rubemnobre/alouatta/Hardware/prototype.png

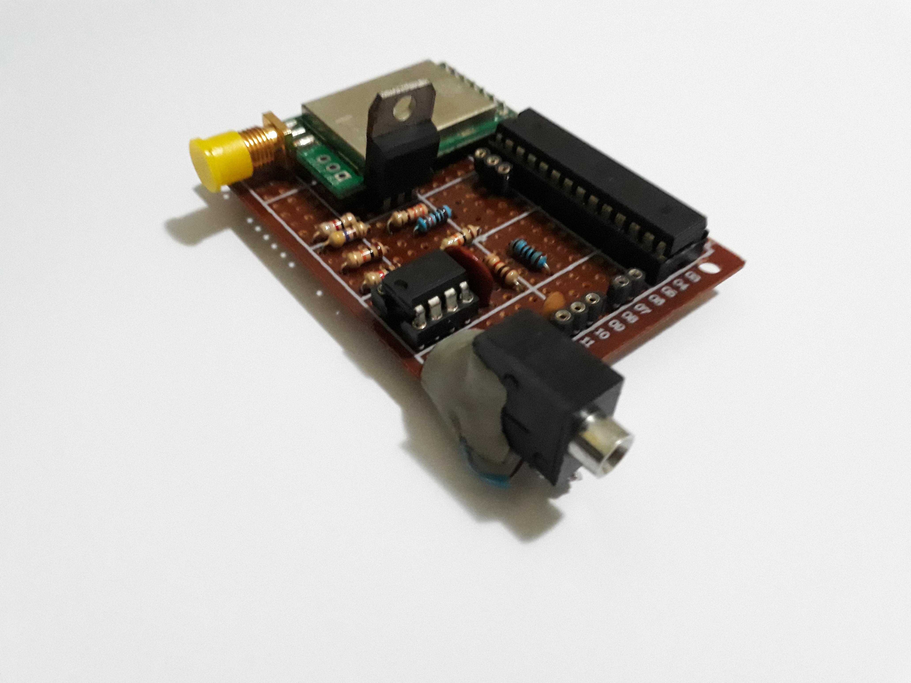
Hardware/prototype.png
