rubemnobre/alouatta/Hardware/schematics-node.png

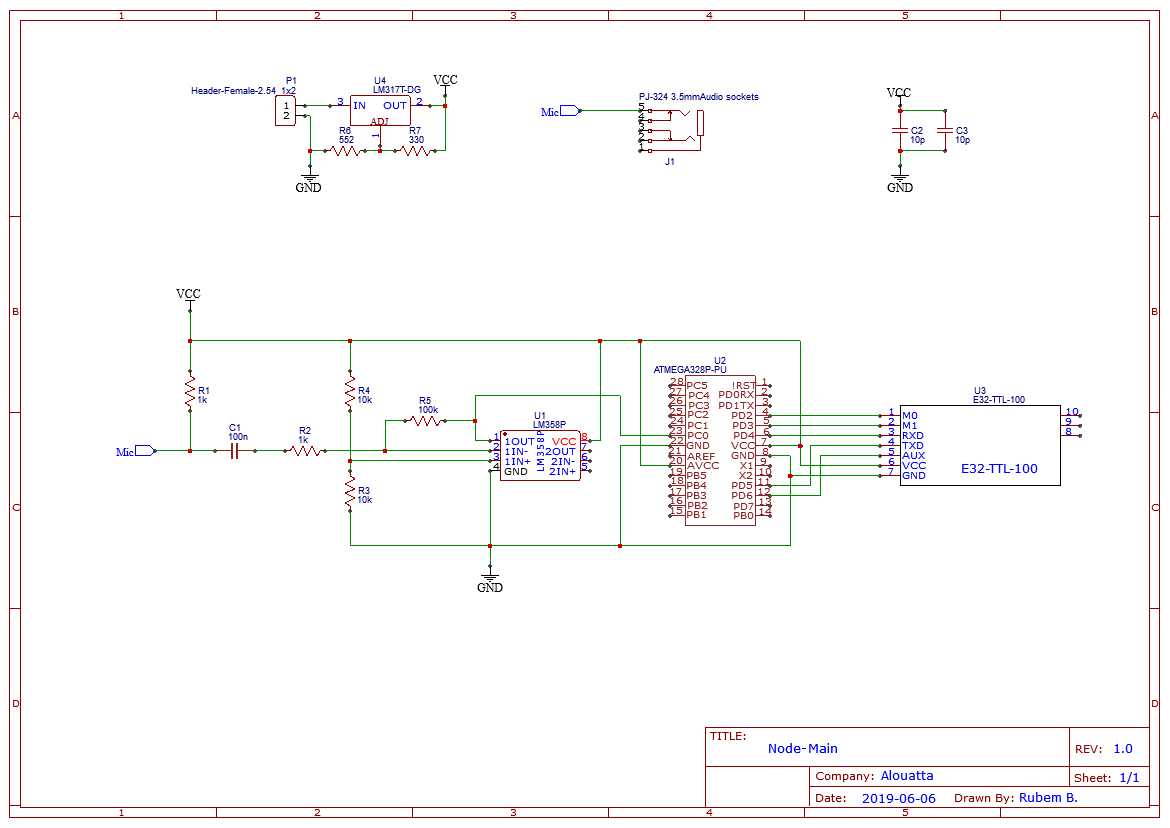
Hardware/schematics-node.png
