rubemnobre/alouatta/(commit log)

2020-03-09 add picture of prototype board
2020-04-19 fix inconsistent space-tabs use
    [alouatta1f.py]
